dr-islam-sa/Bio-pt/ForPrint/main frame outer cover.stl

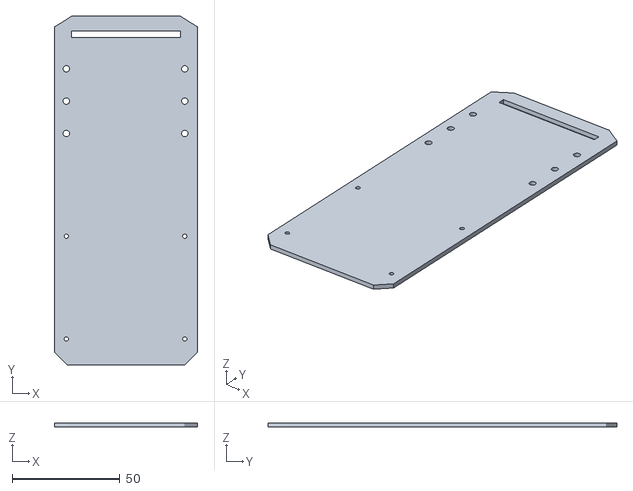
[picture p1: CAD file, 2024-11-10]
ForPrint/main frame outer cover.stl
66.4 x 162.0 x 2.00
