dr-islam-sa/Bio-pt/ForPrint/Main frame.stl

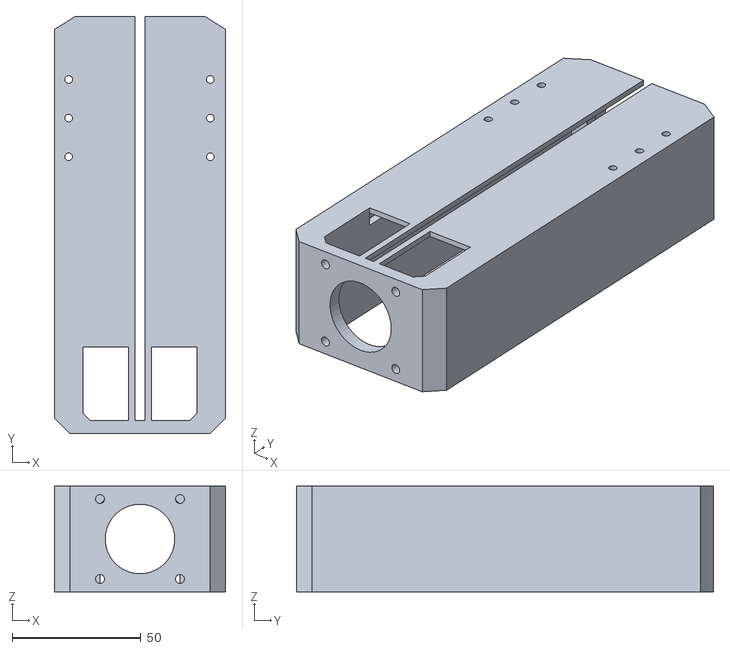
[picture p2: CAD file, 2024-11-10]
ForPrint/Main frame.stl
66.4 x 162.0 x 41.0
