dr-islam-sa/Bio-pt/ForPrint/y axis switch block.stl

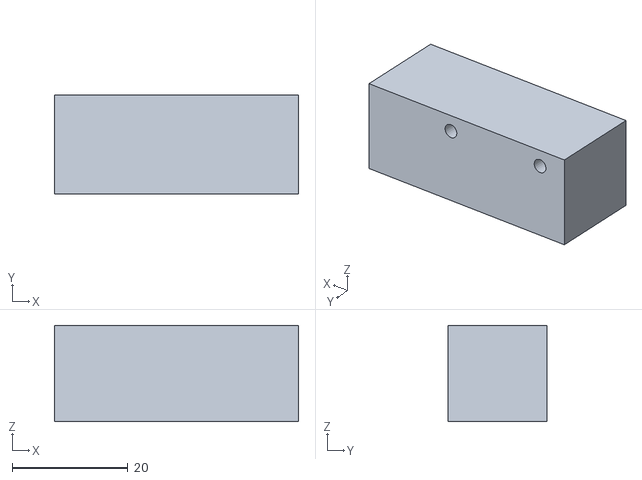
[picture p3: CAD file, 2024-11-10]
ForPrint/y axis switch block.stl
42.1 x 17.0 x 16.6
