dr-islam-sa/Bio-pt/ForPrint/short spacer.stl

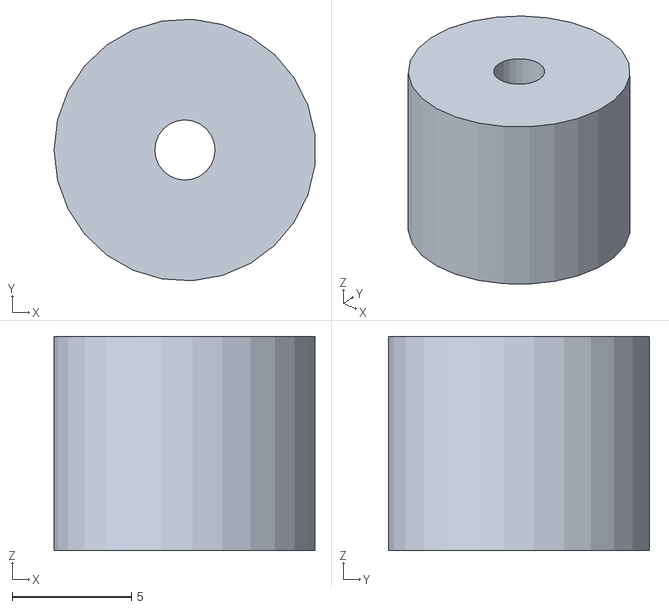
[picture p4: CAD file, 2024-11-10]
ForPrint/short spacer.stl
11.0 x 11.0 x 9.00
