dr-islam-sa/Bio-pt/ForPrint/rail 2.stl

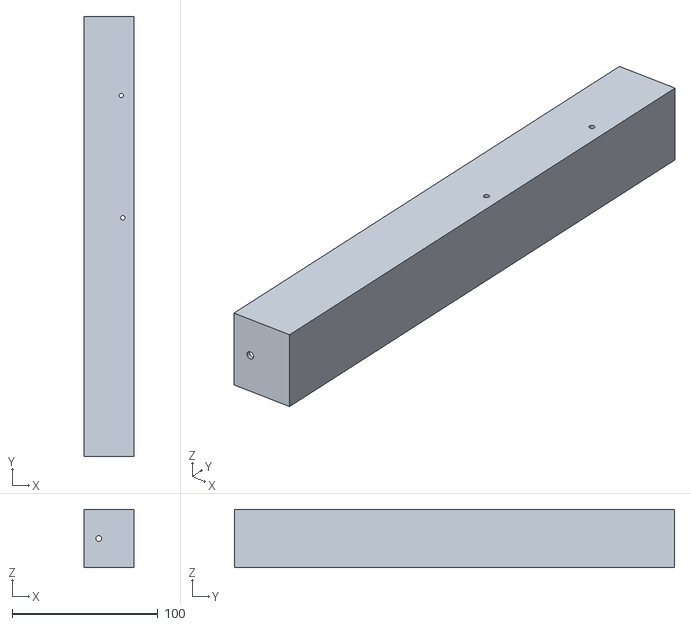
[picture p5: CAD file, 2024-11-10]
ForPrint/rail 2.stl
34.0 x 302.0 x 40.0
