dr-islam-sa/Bio-pt/ForPrint/Bed.stl

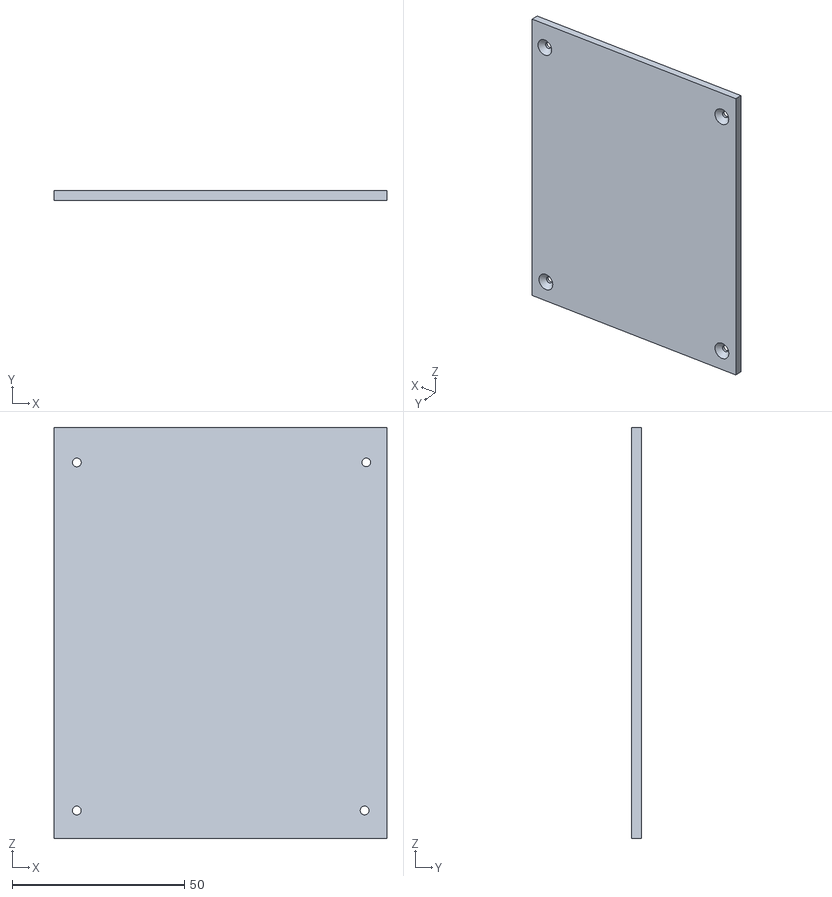
[picture p6: CAD file, 2024-11-10]
ForPrint/Bed.stl
96.6 x 3.00 x 119.3
