dr-islam-sa/Bio-pt/ForPrint/leg.stl

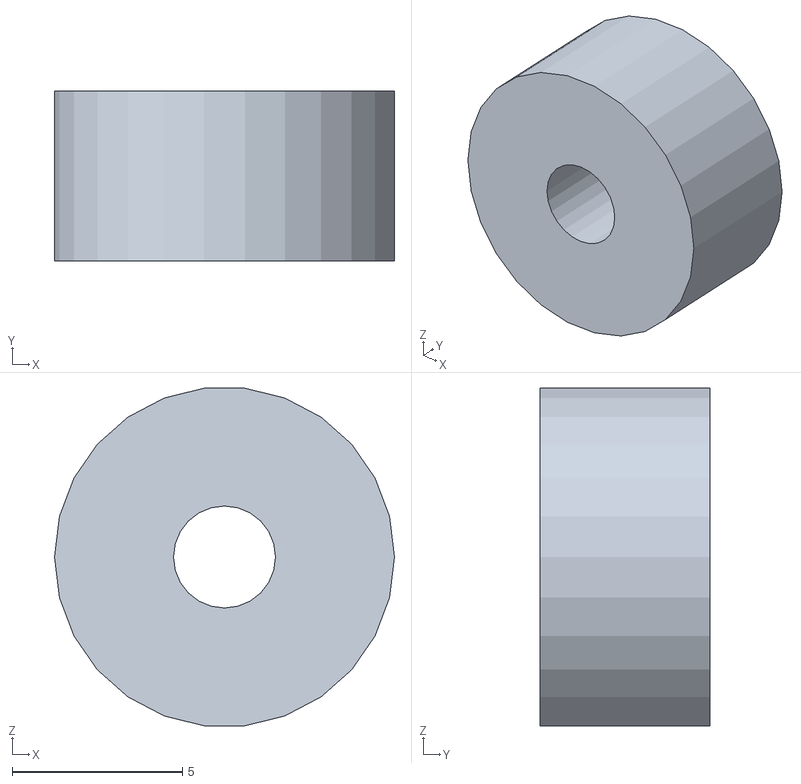
[picture p7: CAD file, 2024-11-10]
ForPrint/leg.stl
10.0 x 5.00 x 9.93
