dr-islam-sa/Bio-pt/ForPrint/Axis plate.stl

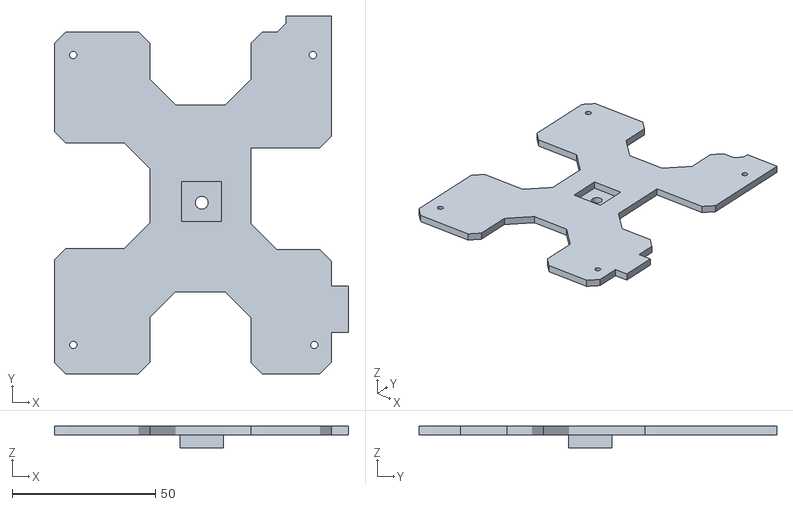
[picture p8: CAD file, 2024-11-10]
ForPrint/Axis plate.stl
102.6 x 124.8 x 7.50
