dr-islam-sa/Bio-pt/ForPrint/Base.stl

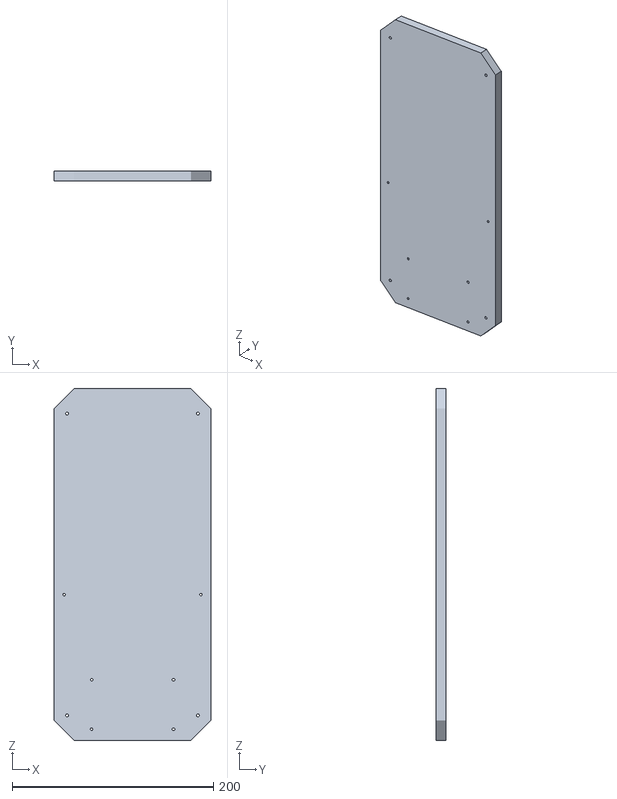
[picture p9: CAD file, 2024-11-10]
ForPrint/Base.stl
156.0 x 10.0 x 350.0
