dr-islam-sa/Bio-pt/ForPrint/long spacer.stl

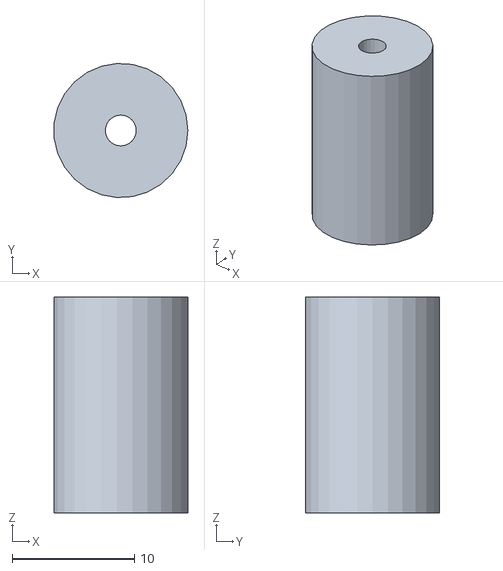
[picture p10: CAD file, 2024-11-10]
ForPrint/long spacer.stl
11.0 x 11.0 x 17.7
