dr-islam-sa/Bio-pt/ForPrint/Upper Plate.stl

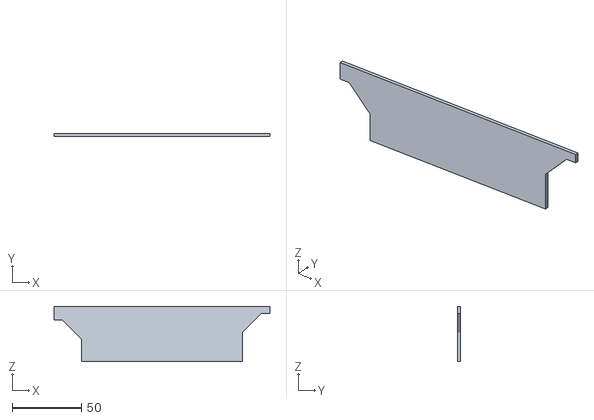
[picture p11: CAD file, 2024-11-10]
ForPrint/Upper Plate.stl
156.0 x 2.00 x 39.9
