dr-islam-sa/Bio-pt/ForPrint/Nema 17 Braket Base.stl

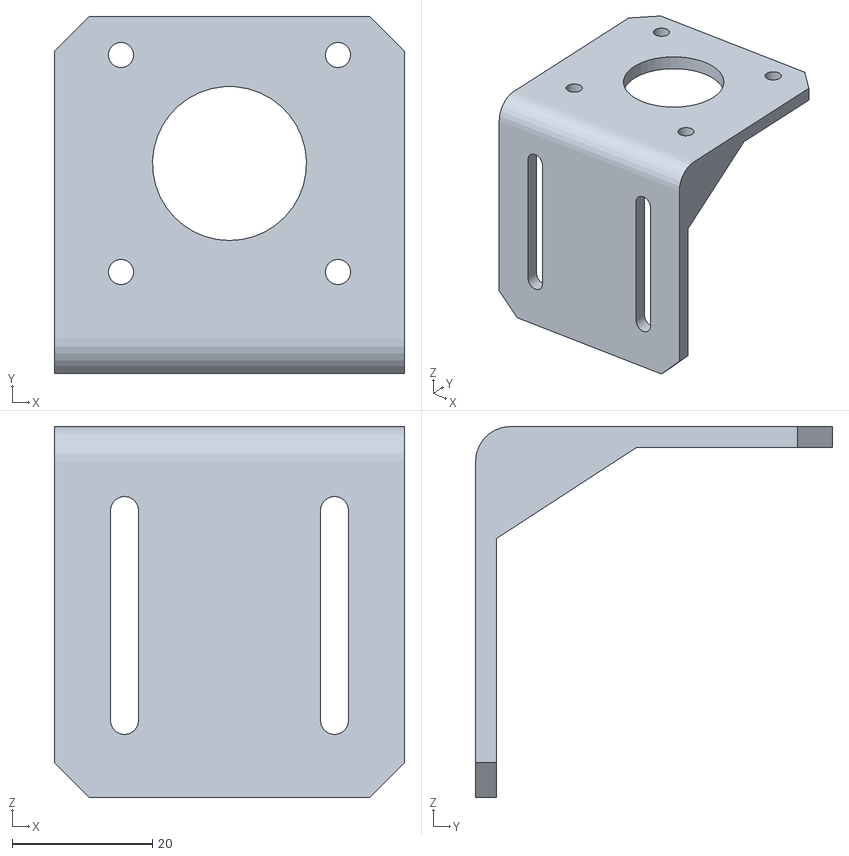
[picture p12: CAD file, 2024-11-10]
ForPrint/Nema 17 Braket Base.stl
50.0 x 51.0 x 53.0
