dr-islam-sa/Bio-pt/ForPrint/Plunger.stl

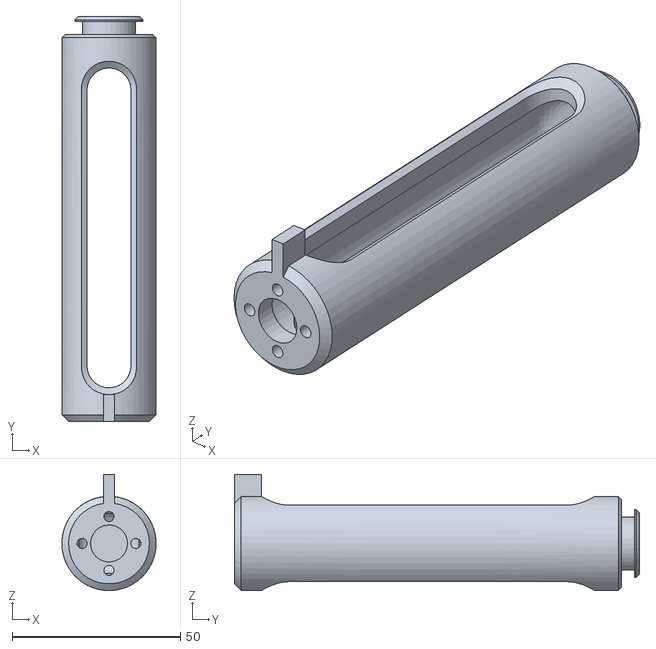
[picture p13: CAD file, 2024-11-10]
ForPrint/Plunger.stl
28.0 x 120.3 x 34.5
