dr-islam-sa/Bio-pt/(list of files, cad)

Other CAD files:
ForPrint/Rail 1.stl
