dr-islam-sa/Bio-pt/assemble guide.pdf

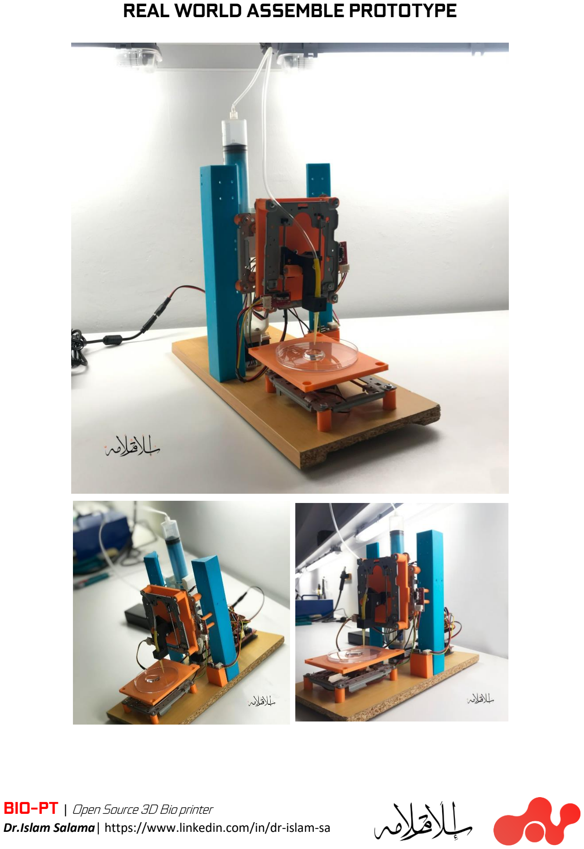
[picture p23: page 10]
